cmcmicrosystems/iot_platform/(list of files, cad)

Other CAD files:
Firmware/source/BLEsensor_cc2650lp_app/TOOLS/src/sysbios/m3_TaskSupport_asm.obj
Firmware/source/BLEsensor_cc2650lp_app/TOOLS/src/sysbios/m3_Hwi_asm_switch.obj
Firmware/source/BLEsensor_cc2650lp_app/TOOLS/src/sysbios/m3_IntrinsicsSupport_asm.obj
Firmware/source/BLEsensor_cc2650lp_app/TOOLS/src/sysbios/m3_Hwi_asm.obj
Firmware/source/BLEsensor_cc2650lp_app/TOOLS/src/sysbios/rom_sysbios.obj
