cmcmicrosystems/iot_platform/PCB_Version_KiCAD_5_1_9/IoT_2021A.kicad_pcb

## KiCad design PCB_Version_KiCAD_5_1_9/IoT_2021A.kicad_pcb (2021-06-30)

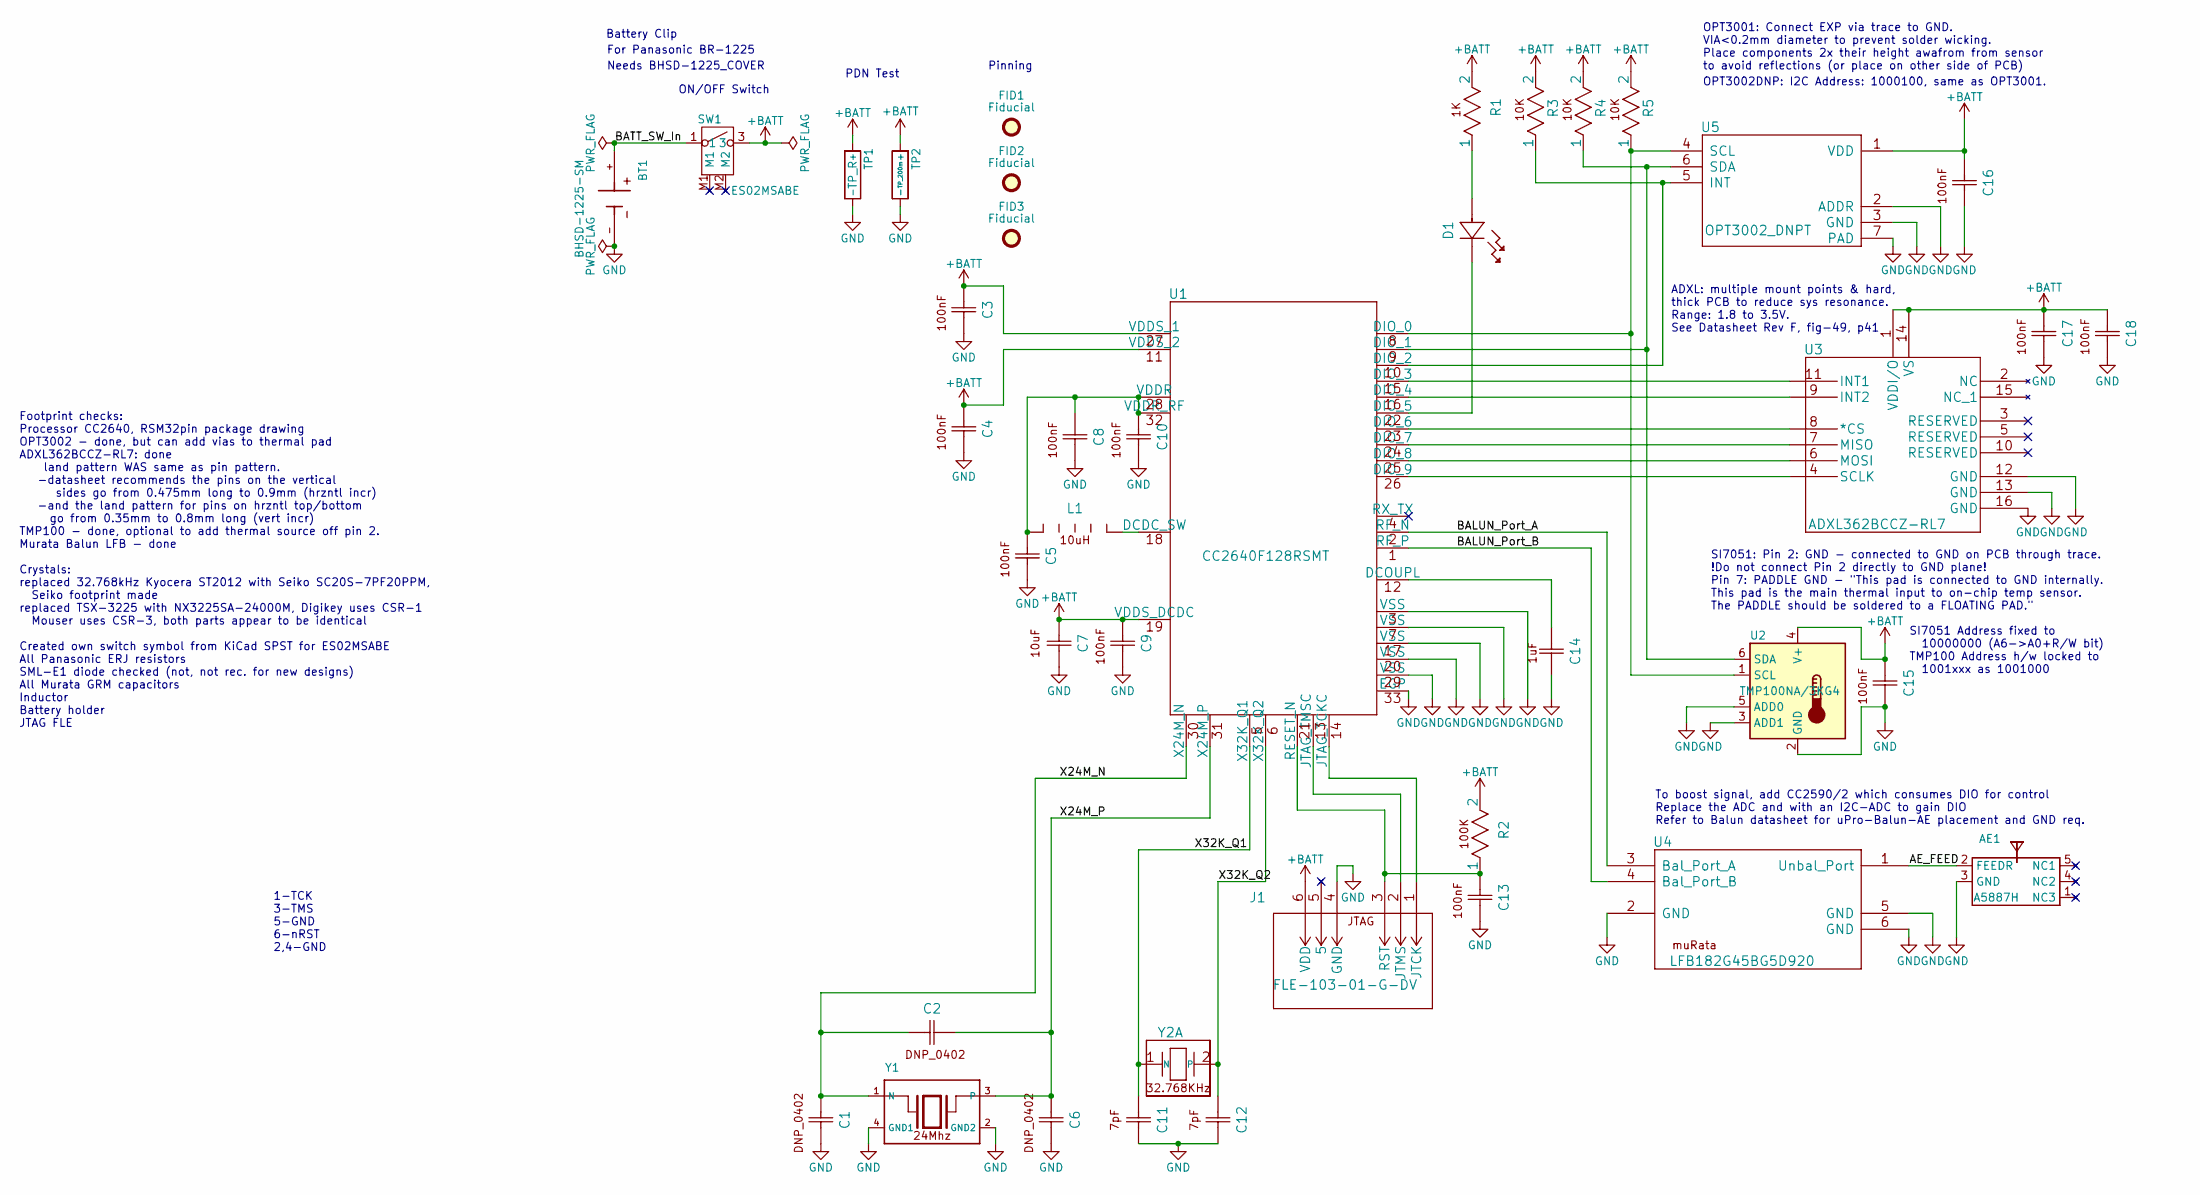
[picture p47: schematic IoT_2021A.sch, IoT2021]

Parts:
AE1: A5887H; RUFA_A5887H_right
BT1: BHSD-1225-SM; BAT_BHSD-1225-SM; PARTREV E
C1, C2, C6: GRM155R70J104KA01D_DNP; GRM155R70J104KA01D
C3, C4, C5, C8, C9, C10, C13, C15, C16, C17, C18: GRM155R70J104KA01D
C7: GRM188R60J106ME47D
C11, C12: GRM1555C1H7R0BA01D
C14: CL05A105KO5NNNC
D1: SMLE12WBC7W1
FID1, FID2, FID3: Fiducial; FID_45mil_NPTH
J1: FLE-103-01-G-DV
L1: CKS2125100M-T
R1: ERJ-2RKF1001X
R2: ERJ-2GEJ104X
R3, R4, R5: ERJ-2GEJ103X
SW1: ES02MSABE; SPST_ES02MSABE_jm
TP1: TP_R
TP2: TP_200m
U1: CC2640F128RSMT
U2: TMP100NA/3KG4; SOT-23-6
U3: ADXL362BCCZ-RL7
U4: LFB182G45BG5D920; Murata_SMD_6_balun
U5: OPT3002_DNPT; OPT3002DNPT_6_USON_SON65P200X200X65-7N
Y1: NX3225SA-24.000M-STD-CSR-1; NX3225SA_STD_CSR; PARTREV N/A
Y2: SC20S-7PF20PPM; SC20S_7PF20PPM_footprint

Connections:
+BATT: C3.1, C4.1, C7.1, C9.1, C15.1, C16.1, C17.1, C18.1, J1.6 (VDD), R1.2, R2.2, R3.2, R4.2, R5.2, SW1.3, TP1.1 (+), TP2.1 (+), U1.11 (VDDS_2), U1.19 (VDDS_DCDC), U1.27 (VDDS_1), U2.4 (V+), U3.1 (VDDI/O), U3.14 (VS), U5.1 (VDD)
/AE_FEED: AE1.2 (FEEDR), U4.1 (Unbal_Port)
/BALUN_Port_A: U1.2 (RF_N), U4.3 (Bal_Port_A)
/BALUN_Port_B: U1.1 (RF_P), U4.4 (Bal_Port_B)
/BATT_SW_In: BT1.+, SW1.1
/X24M_N: C1.1, C2.1, U1.30 (X24M_N), Y1.1 (N)
/X24M_P: C2.2, C6.1, U1.31 (X24M_P), Y1.3
/X32K_Q1: C11.1, U1.5 (X32K_Q1), Y2.1 (N)
/X32K_Q2: C12.1, U1.6 (X32K_Q2), Y2.2
GND: AE1.3 (GND), BT1.-, C1.2, C3.2, C4.2, C5.2, C6.2, C7.2, C8.2, C9.2, C10.2, C11.2, C12.2, C13.2, C14.2, C15.2, C16.2, C17.2, C18.2, J1.4 (GND), TP1.2 (-), TP2.2 (-), U1.3 (VSS), U1.7 (VSS), U1.17 (VSS), U1.20 (VSS), U1.29 (VSS), U1.33 (EGP), U2.2 (GND), U2.3 (ADD1), U2.5 (ADD0), U3.12 (GND), U3.13 (GND), U3.16 (GND), U4.2 (GND), U4.5 (GND), U4.6 (GND), U5.2 (ADDR), U5.3 (GND), U5.7 (PAD), Y1.2 (GND2), Y1.4 (GND1)
unnamed: C5.1, C8.1, C10.1, L1.2, U1.28 (VDDR), U1.32 (VDDR_RF)
unnamed: C13.1, J1.3 (RST), R2.1, U1.21 (RESET_N)
unnamed: C14.1, U1.12 (DCOUPL)
unnamed: D1.1, U1.22 (DIO_5)
unnamed: D1.2, R1.1
unnamed: J1.1 (JTCK), U1.14 (JTAG_TCKC)
unnamed: J1.2 (JTMS), U1.13 (JTAG_TMSC)
unnamed: L1.1, U1.18 (DCDC_SW)
unnamed: R3.1, U1.10 (DIO_2), U5.5 (INT)
unnamed: R4.1, U1.9 (DIO_1), U2.6 (SDA), U5.6 (SDA)
unnamed: R5.1, U1.8 (DIO_0), U2.1 (SCL), U5.4 (SCL)
unnamed: U1.15 (DIO_3), U3.11 (INT1)
unnamed: U1.16 (DIO_4), U3.9 (INT2)
unnamed: U1.23 (DIO_6), U3.8 (*CS)
unnamed: U1.24 (DIO_7), U3.7 (MISO)
unnamed: U1.25 (DIO_8), U3.6 (MOSI)
unnamed: U1.26 (DIO_9), U3.4 (SCLK)

Notes on the sheet:
Battery Clip
For Panasonic BR-1225
Needs BHSD-1225_COVER
PDN Test
ON/OFF Switch
To boost signal, add CC2590/2 which consumes DIO for control Replace the ADC and with an I2C-ADC to gain DIO Refer to Balun datasheet for uPro-Balun-AE placement and GND req.
OPT3001: Connect EXP via trace to GND. VIA<0.2mm diameter to prevent solder wicking. Place components 2x their height awafrom from sensor to avoid reflections (or place on other side of PCB)
ADXL: multiple mount points & hard, thick PCB to reduce sys resonance. Range: 1.8 to 3.5V. See Datasheet Rev F, fig-49, p41
SI7051: Pin 2: GND - connected to GND on PCB through trace. !Do not connect Pin 2 directly to GND plane! Pin 7: PADDLE GND - "This pad is connected to GND internally. This pad is the main thermal input to on-chip temp sensor. The PADDLE should be soldered to a FLOATING PAD."
OPT3002DNP: I2C Address: 1000100, same as OPT3001.
SI7051 Address fixed to 10000000 (A6->A0+R/W bit) TMP100 Address h/w locked to 1001xxx as 1001000
1-TCK 3-TMS 5-GND 6-nRST 2,4-GND
Pinning
Footprint checks: Processor CC2640, RSM32pin package drawing OPT3002 - done, but can add vias to thermal pad ADXL362BCCZ-RL7: done land pattern WAS same as pin pattern. -datasheet recommends the pins on the vertical sides go from 0.475mm long to 0.9mm (hrzntl incr) -and the land pattern for pins on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

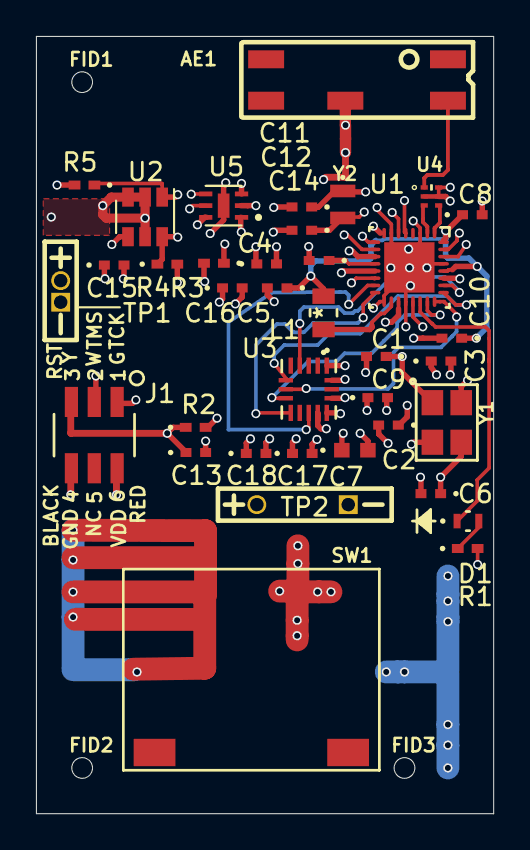
[picture p48: board IoT_2021A.kicad_pcb from above]

Board: 6 copper layers, 25.4 x 43.2 mm, 41 parts (1 on the bottom side), 27 nets.
