cmcmicrosystems/iot_platform/(commit log)

2020-05-06 HPS source files added
    [Reference_Design_1_BLE sensor.sch, Reference_Design_1_BLE_sensor.pcb, Reference_Design_1_BLE_sensor_flooded.pcb, app_ble.cfg, app_ble_pem3.cfg, build.cfg, m3_Hwi_asm.obj, m3_Hwi_asm_switch.obj]
2021-06-30 Beta Version, KiCad 5.1.9, hardware only, firmware to come
    [IoT_2021A.kicad_pcb, IoT_2021A.sch, Reference_Design_1_BLE sensor.sch, Reference_Design_1_BLE_sensor.pcb, Reference_Design_1_BLE_sensor_flooded.pcb, STACKUP_IoT2021A_ForFab.xlsx, app_ble.cfg, app_ble_pem3.cfg]
2021-11-03 update the firmware code with intervals suitable for battery operation
2021-11-08 BETA Release, Hardware and Software Supported, Battery Operation. SwiftMote IoT2021A.
